prakashlab/octopi-driver-board/ODSv1.0.0-BP-Jmp/ODSv1.0.0-BP-Jmp.kicad_pcb

## KiCad design ODSv1.0.0-BP-Jmp/ODSv1.0.0-BP-Jmp.kicad_pcb (2021-03-19)

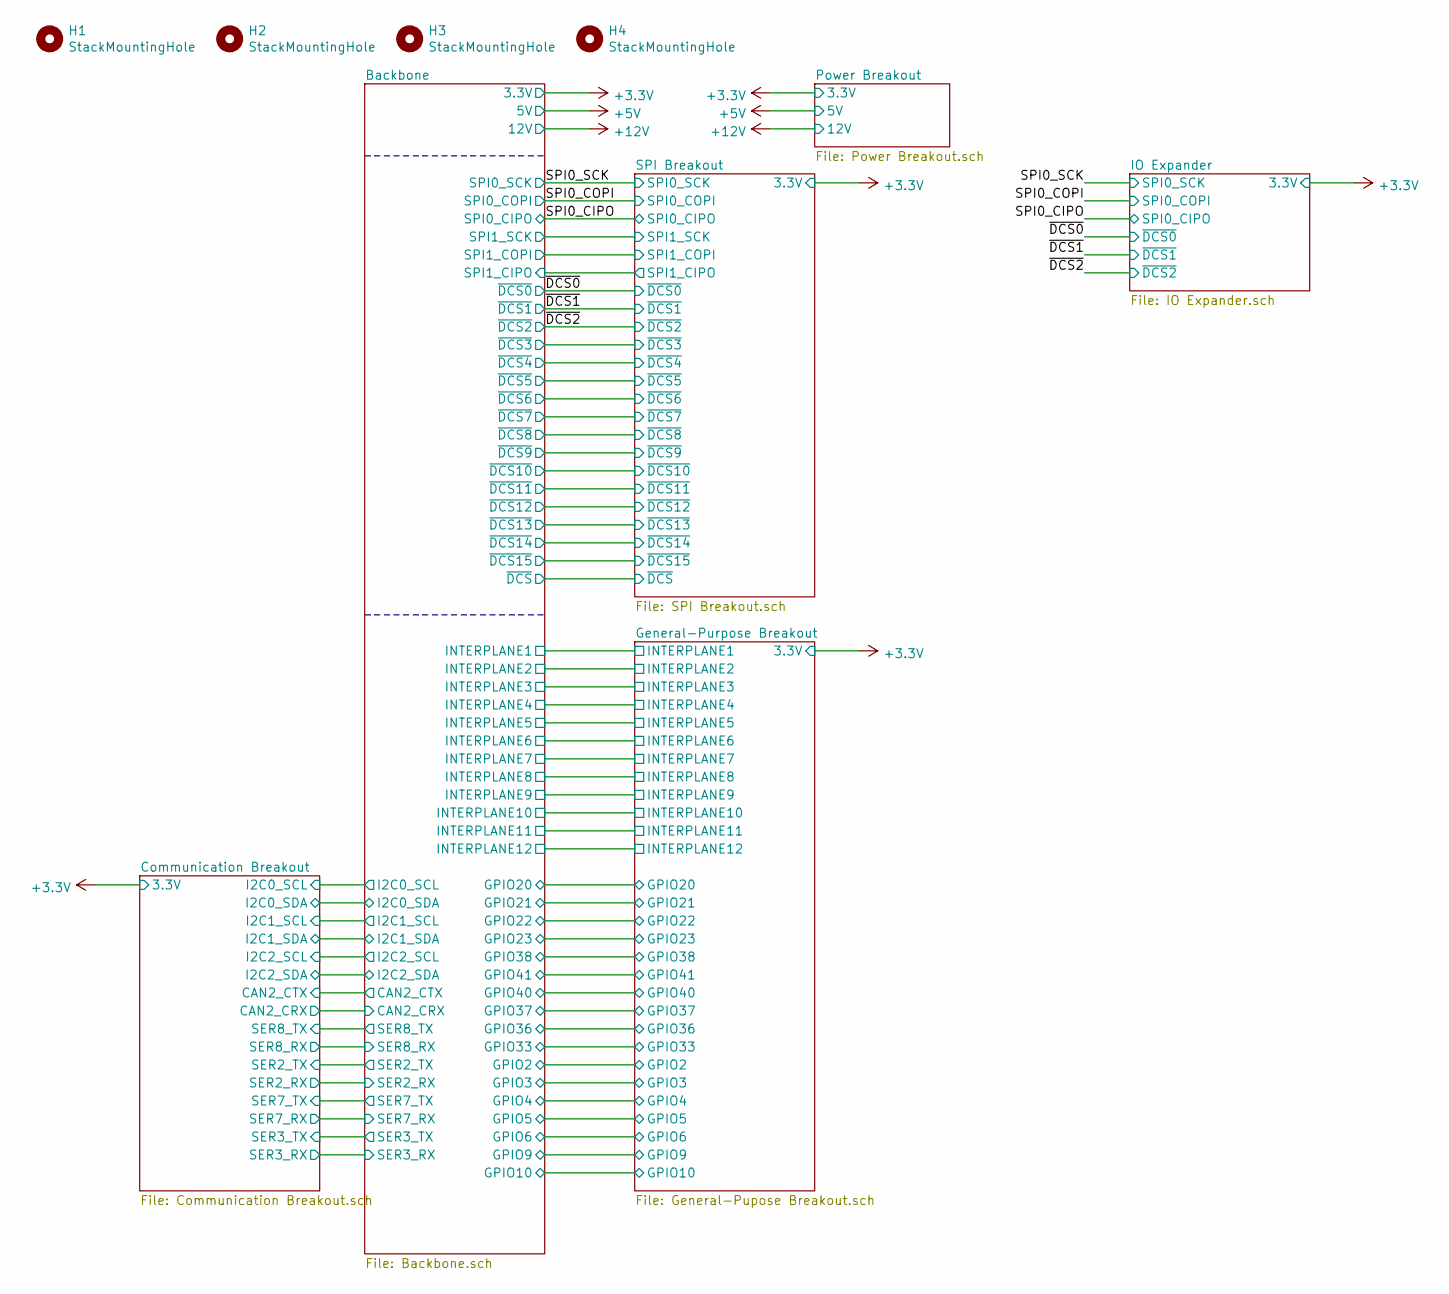
[picture p3: schematic ODSv1.0.0-BP-Jmp.sch, Breakout Plane for Jumper Wires]

Parts:
H1, H2, H3, H4: StackMountingHole; MountingHole_3.2mm_M3

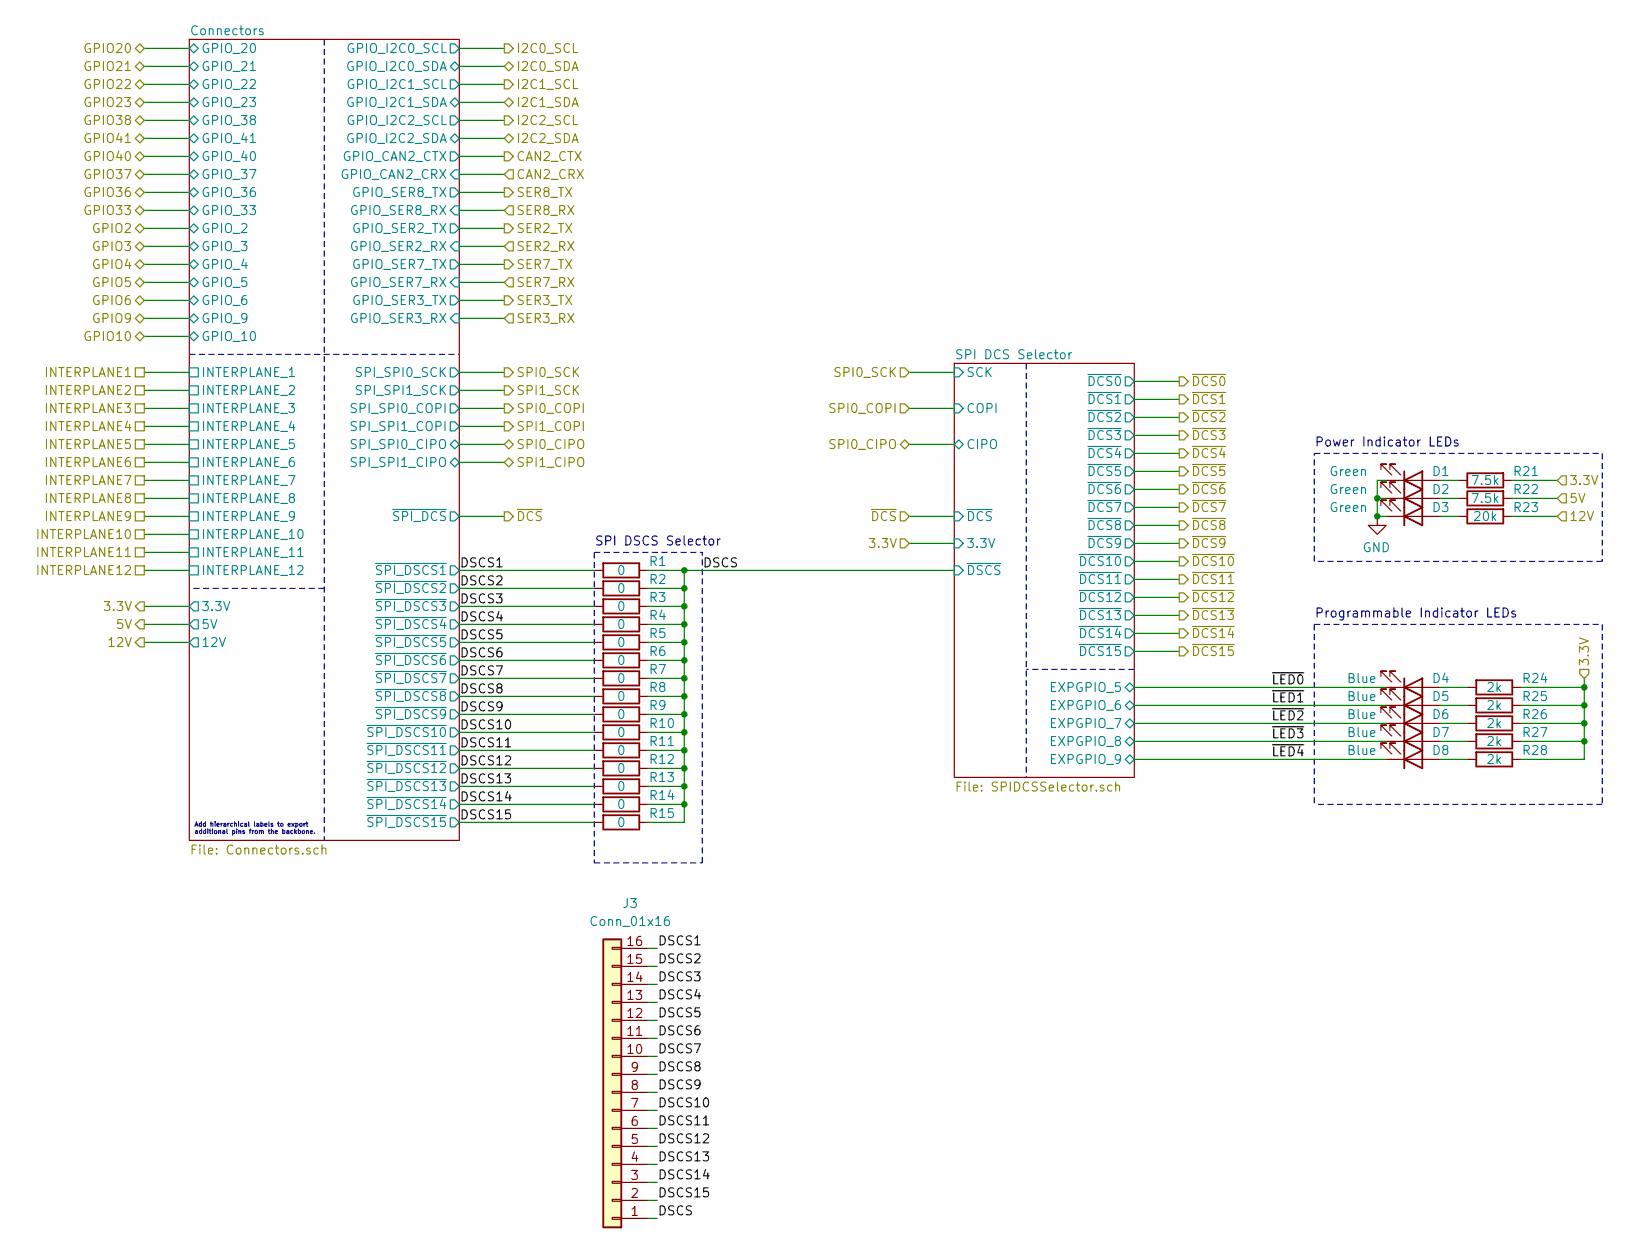
[picture p4: schematic Backbone.sch, Breakout Plane for Jumper Wires]

Parts:
D1, D2, D3: Green; LED_0603_1608Metric; MPN 150060GS75000; Digikey ID 732-4971-1-ND
D4, D5, D6, D7, D8: Blue; LED_0603_1608Metric; MPN 150060BS75000; Digikey ID 732-4966-1-ND
J3: Conn_01x16; Harwin_M20-89016xx_1x16_P2.54mm_Horizontal; MPN GEC16SBSN-M89; Digikey ID S1113E-16-ND
R1, R2, R3, R4, R5, R6, R7, R8, R9, R10, R11, R12, R13, R14, R15: 0; R_1206_3216Metric_Pad1.30x1.75mm_HandSolder; MPN RC1206JR-070RL; Digikey ID 311-0.0ERCT-ND
R21, R22: 7.5k; R_0603_1608Metric; MPN RC0603FR-077K5L; Digikey ID 311-7.50KHRCT-ND
R23: 20k; R_0603_1608Metric; MPN RC0603FR-0720KL; Digikey ID 311-20.0KHRCT-ND
R24, R25, R26, R27, R28: 2k; R_0603_1608Metric; MPN RC0603FR-0720KL; Digikey ID 311-20.0KHRCT-ND

Connections:
+3V3: R21.2, R24.1, R25.1, R26.1, R27.1, R28.1; also elsewhere on the board
+5V: R22.2; also elsewhere on the board
+12V: R23.2; also elsewhere on the board
/Backbone/DSCS: J3.1, R1.1, R2.1, R3.1, R4.1, R5.1, R6.1, R7.1, R8.1, R9.1, R10.1, R11.1, R12.1, R13.1, R14.1, R15.1; also elsewhere on the board
/Backbone/DSCS1: J3.16, R1.2; also elsewhere on the board
/Backbone/DSCS2: J3.15, R2.2; also elsewhere on the board
/Backbone/DSCS3: J3.14, R3.2; also elsewhere on the board
/Backbone/DSCS4: J3.13, R4.2; also elsewhere on the board
/Backbone/DSCS5: J3.12, R5.2; also elsewhere on the board
/Backbone/DSCS6: J3.11, R6.2; also elsewhere on the board
/Backbone/DSCS7: J3.10, R7.2; also elsewhere on the board
/Backbone/DSCS8: J3.9, R8.2; also elsewhere on the board
/Backbone/DSCS9: J3.8, R9.2; also elsewhere on the board
/Backbone/DSCS10: J3.7, R10.2; also elsewhere on the board
/Backbone/DSCS11: J3.6, R11.2; also elsewhere on the board
/Backbone/DSCS12: J3.5, R12.2; also elsewhere on the board
/Backbone/DSCS13: J3.4, R13.2; also elsewhere on the board
/Backbone/DSCS14: J3.3, R14.2; also elsewhere on the board
/Backbone/DSCS15: J3.2, R15.2; also elsewhere on the board
/Backbone/~LED0~: D4.1 (K); also elsewhere on the board
/Backbone/~LED1~: D5.1 (K); also elsewhere on the board
/Backbone/~LED2~: D6.1 (K); also elsewhere on the board
/Backbone/~LED3~: D7.1 (K); also elsewhere on the board
/Backbone/~LED4~: D8.1 (K); also elsewhere on the board
GND: D1.1 (K), D2.1 (K), D3.1 (K); also elsewhere on the board
unnamed: D1.2 (A), R21.1
unnamed: D2.2 (A), R22.1
unnamed: D3.2 (A), R23.1
unnamed: D4.2 (A), R24.2
unnamed: D5.2 (A), R25.2
unnamed: D6.2 (A), R26.2
unnamed: D7.2 (A), R27.2
unnamed: D8.2 (A), R28.2

Notes on the sheet:
SPI DSCS Selector
Power Indicator LEDs
Programmable Indicator LEDs
Add hierarchical labels to export additional pins from the backbone.

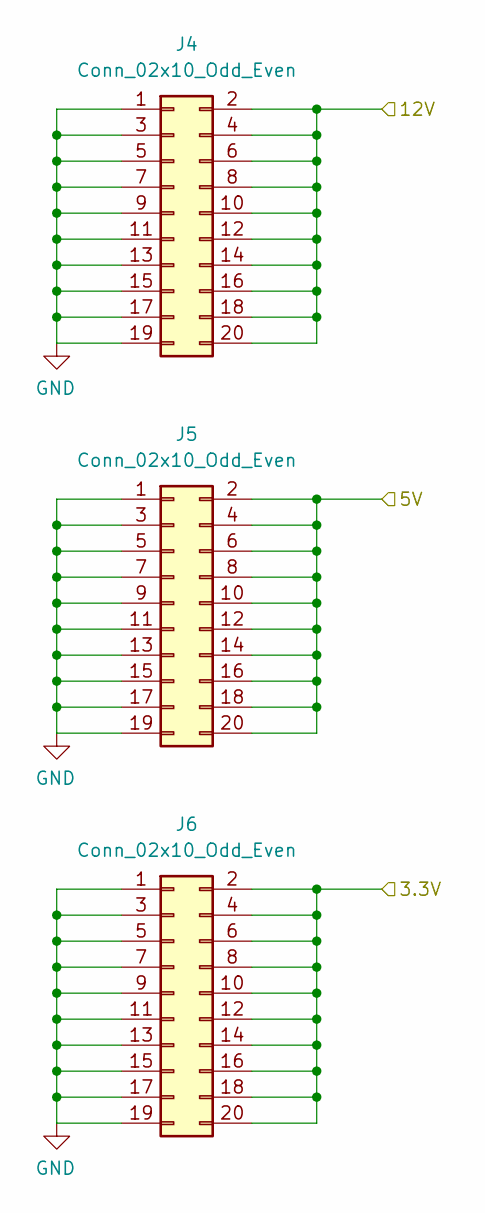
[picture p5: schematic Power Breakout.sch, Breakout Plane for Jumper Wires]

Parts:
J4, J5, J6: Conn_02x10_Odd_Even; Samtec_TSM-110-01-X-DH_2x10_P2.54mm_Horizontal; MPN TSM-110-01-T-DH; Digikey ID SAM15910-ND

Connections:
+3V3: J6.2, J6.4, J6.6, J6.8, J6.10, J6.12, J6.14, J6.16, J6.18, J6.20; also elsewhere on the board
+5V: J5.2, J5.4, J5.6, J5.8, J5.10, J5.12, J5.14, J5.16, J5.18, J5.20; also elsewhere on the board
+12V: J4.2, J4.4, J4.6, J4.8, J4.10, J4.12, J4.14, J4.16, J4.18, J4.20; also elsewhere on the board
GND: J4.1, J4.3, J4.5, J4.7, J4.9, J4.11, J4.13, J4.15, J4.17, J4.19, J5.1, J5.3, J5.5, J5.7, J5.9, J5.11, J5.13, J5.15, J5.17, J5.19, J6.1, J6.3, J6.5, J6.7, J6.9, J6.11, J6.13, J6.15, J6.17, J6.19; also elsewhere on the board

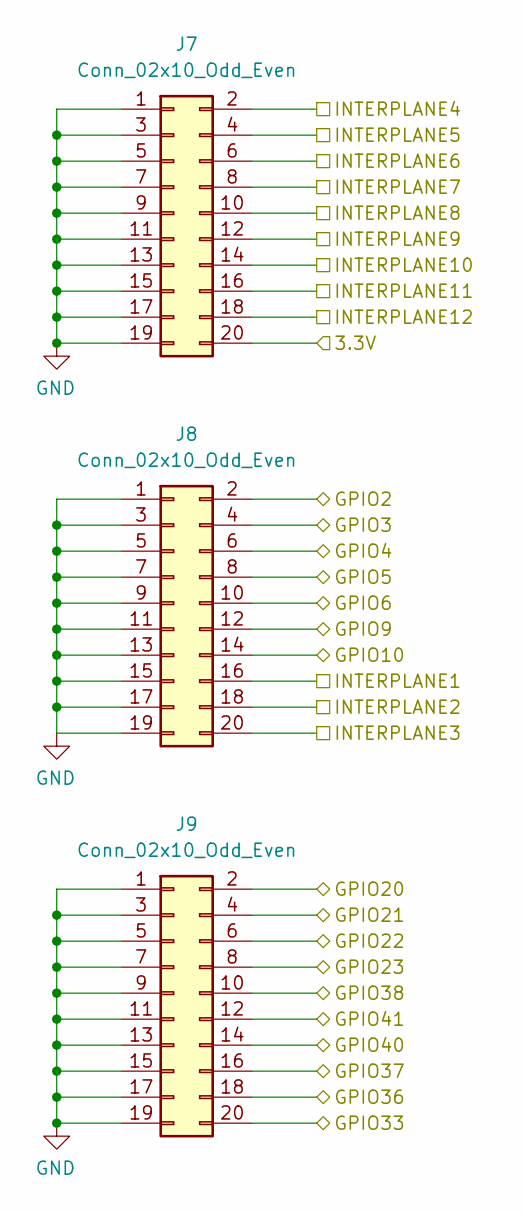
[picture p6: schematic General-Pupose Breakout.sch, Breakout Plane for Jumper Wires]

Parts:
J7, J8, J9: Conn_02x10_Odd_Even; Samtec_TSM-110-01-X-DH_2x10_P2.54mm_Horizontal; MPN TSM-110-01-T-DH; Digikey ID SAM15910-ND

Connections:
+3V3: J7.20; also elsewhere on the board
/Backbone/GPIO2: J8.2; also elsewhere on the board
/Backbone/GPIO3: J8.4; also elsewhere on the board
/Backbone/GPIO4: J8.6; also elsewhere on the board
/Backbone/GPIO5: J8.8; also elsewhere on the board
/Backbone/GPIO6: J8.10; also elsewhere on the board
/Backbone/GPIO9: J8.12; also elsewhere on the board
/Backbone/GPIO10: J8.14; also elsewhere on the board
/Backbone/GPIO20: J9.2; also elsewhere on the board
/Backbone/GPIO21: J9.4; also elsewhere on the board
/Backbone/GPIO22: J9.6; also elsewhere on the board
/Backbone/GPIO23: J9.8; also elsewhere on the board
/Backbone/GPIO33: J9.20; also elsewhere on the board
/Backbone/GPIO36: J9.18; also elsewhere on the board
/Backbone/GPIO37: J9.16; also elsewhere on the board
/Backbone/GPIO38: J9.10; also elsewhere on the board
/Backbone/GPIO40: J9.14; also elsewhere on the board
/Backbone/GPIO41: J9.12; also elsewhere on the board
/Backbone/INTERPLANE1: J8.16; also elsewhere on the board
/Backbone/INTERPLANE2: J8.18; also elsewhere on the board
/Backbone/INTERPLANE3: J8.20; also elsewhere on the board
/Backbone/INTERPLANE4: J7.2; also elsewhere on the board
/Backbone/INTERPLANE5: J7.4; also elsewhere on the board
/Backbone/INTERPLANE6: J7.6; also elsewhere on the board
/Backbone/INTERPLANE7: J7.8; also elsewhere on the board
/Backbone/INTERPLANE8: J7.10; also elsewhere on the board
/Backbone/INTERPLANE9: J7.12; also elsewhere on the board
/Backbone/INTERPLANE10: J7.14; also elsewhere on the board
/Backbone/INTERPLANE11: J7.16; also elsewhere on the board
/Backbone/INTERPLANE12: J7.18; also elsewhere on the board
GND: J7.1, J7.3, J7.5, J7.7, J7.9, J7.11, J7.13, J7.15, J7.17, J7.19, J8.1, J8.3, J8.5, J8.7, J8.9, J8.11, J8.13, J8.15, J8.17, J8.19, J9.1, J9.3, J9.5, J9.7, J9.9, J9.11, J9.13, J9.15, J9.17, J9.19; also elsewhere on the board

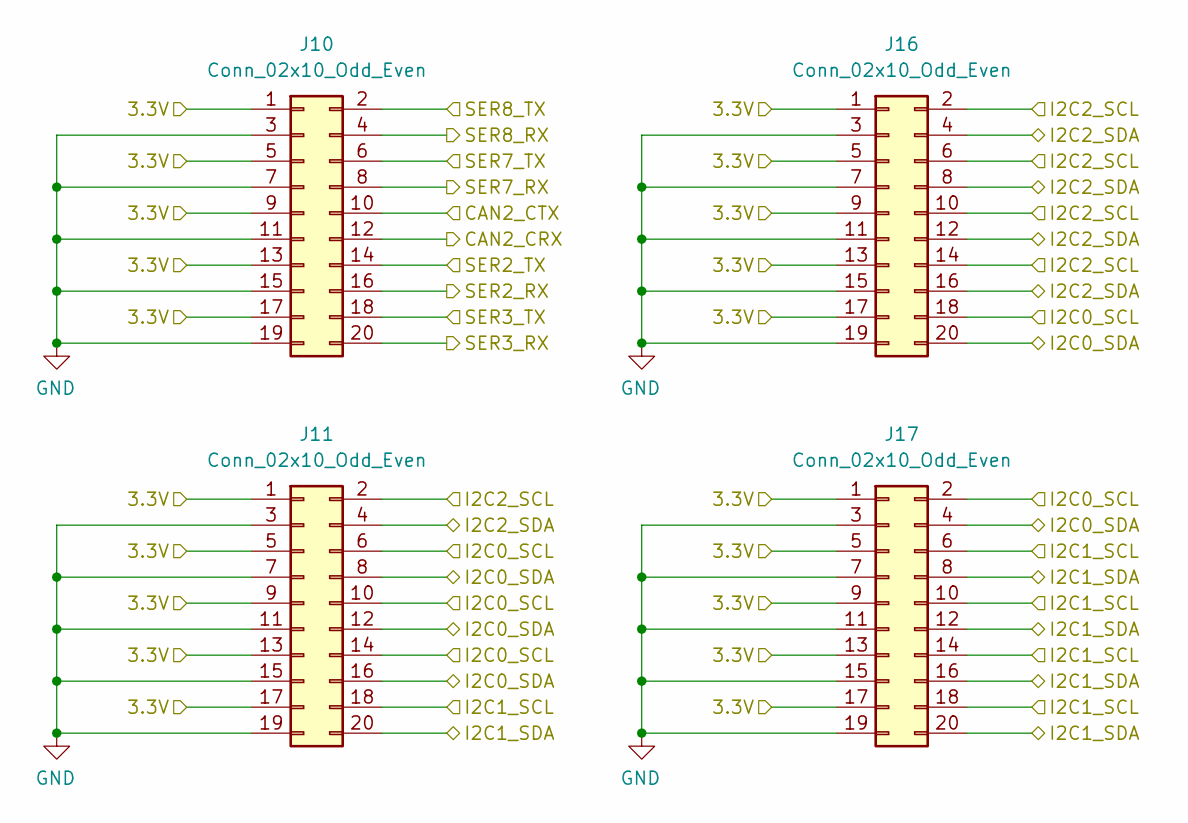
[picture p7: schematic Communication Breakout.sch, Breakout Plane for Jumper Wires]

Parts:
J10, J11: Conn_02x10_Odd_Even; Samtec_TSM-110-01-X-DH_2x10_P2.54mm_Horizontal; MPN TSM-110-01-T-DH; Digikey ID SAM15910-ND
J16, J17: Conn_02x10_Odd_Even; PinHeader_2x10_P2.54mm_Vertical_SMD; MPN TSM-110-01-T-DV; Digikey ID SAM8990-ND

Connections:
+3V3: J10.1, J10.5, J10.9, J10.13, J10.17, J11.1, J11.5, J11.9, J11.13, J11.17, J16.1, J16.5, J16.9, J16.13, J16.17, J17.1, J17.5, J17.9, J17.13, J17.17; also elsewhere on the board
/Backbone/CAN2_CRX: J10.12; also elsewhere on the board
/Backbone/CAN2_CTX: J10.10; also elsewhere on the board
/Backbone/I2C0_SCL: J11.6, J11.10, J11.14, J16.18, J17.2; also elsewhere on the board
/Backbone/I2C0_SDA: J11.8, J11.12, J11.16, J16.20, J17.4; also elsewhere on the board
/Backbone/I2C1_SCL: J11.18, J17.6, J17.10, J17.14, J17.18; also elsewhere on the board
/Backbone/I2C1_SDA: J11.20, J17.8, J17.12, J17.16, J17.20; also elsewhere on the board
/Backbone/I2C2_SCL: J11.2, J16.2, J16.6, J16.10, J16.14; also elsewhere on the board
/Backbone/I2C2_SDA: J11.4, J16.4, J16.8, J16.12, J16.16; also elsewhere on the board
/Backbone/SER2_RX: J10.16; also elsewhere on the board
/Backbone/SER2_TX: J10.14; also elsewhere on the board
/Backbone/SER3_RX: J10.20; also elsewhere on the board
/Backbone/SER3_TX: J10.18; also elsewhere on the board
/Backbone/SER7_RX: J10.8; also elsewhere on the board
/Backbone/SER7_TX: J10.6; also elsewhere on the board
/Backbone/SER8_RX: J10.4; also elsewhere on the board
/Backbone/SER8_TX: J10.2; also elsewhere on the board
GND: J10.3, J10.7, J10.11, J10.15, J10.19, J11.3, J11.7, J11.11, J11.15, J11.19, J16.3, J16.7, J16.11, J16.15, J16.19, J17.3, J17.7, J17.11, J17.15, J17.19; also elsewhere on the board

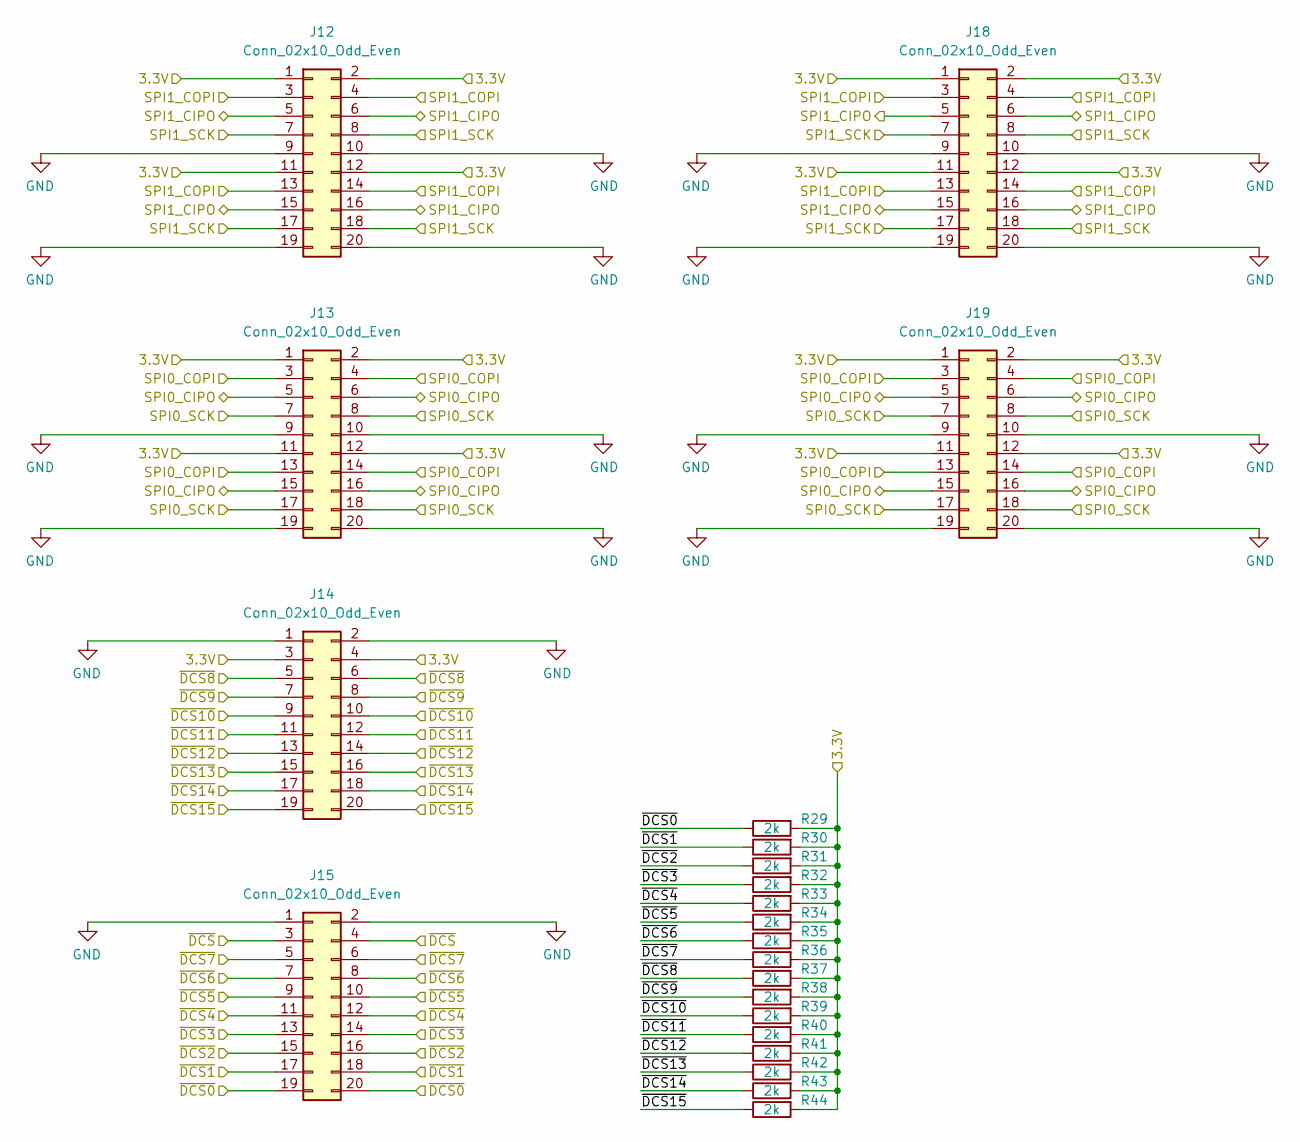
[picture p8: schematic SPI Breakout.sch, Breakout Plane for Jumper Wires]

Parts:
J12, J13, J14: Conn_02x10_Odd_Even; Samtec_TSM-110-01-X-DH_2x10_P2.54mm_Horizontal; MPN TSM-110-01-T-DH; Digikey ID SAM15910-ND
J15, J18, J19: Conn_02x10_Odd_Even; PinHeader_2x10_P2.54mm_Vertical_SMD; MPN TSM-110-01-T-DV; Digikey ID SAM8990-ND
R29, R30, R31, R32, R33, R34, R35, R36, R37, R38, R39, R40, R41, R42, R43, R44: 2k; R_0603_1608Metric; MPN RC0603FR-0720KL; Digikey ID 311-20.0KHRCT-ND

Connections:
+3V3: J12.1, J12.2, J12.11, J12.12, J13.1, J13.2, J13.11, J13.12, J14.3, J14.4, J18.1, J18.2, J18.11, J18.12, J19.1, J19.2, J19.11, J19.12, R29.2, R30.2, R31.2, R32.2, R33.2, R34.2, R35.2, R36.2, R37.2, R38.2, R39.2, R40.2, R41.2, R42.2, R43.2, R44.2; also elsewhere on the board
/Backbone/SPI1_CIPO: J12.5, J12.6, J12.15, J12.16, J18.5, J18.6, J18.15, J18.16; also elsewhere on the board
/Backbone/SPI1_COPI: J12.3, J12.4, J12.13, J12.14, J18.3, J18.4, J18.13, J18.14; also elsewhere on the board
/Backbone/SPI1_SCK: J12.7, J12.8, J12.17, J12.18, J18.7, J18.8, J18.17, J18.18; also elsewhere on the board
/Backbone/~DCS3~: J15.13, J15.14, R32.1; also elsewhere on the board
/Backbone/~DCS4~: J15.11, J15.12, R33.1; also elsewhere on the board
/Backbone/~DCS5~: J15.9, J15.10, R34.1; also elsewhere on the board
/Backbone/~DCS6~: J15.7, J15.8, R35.1; also elsewhere on the board
/Backbone/~DCS7~: J15.5, J15.6, R36.1; also elsewhere on the board
/Backbone/~DCS8~: J14.5, J14.6, R37.1; also elsewhere on the board
/Backbone/~DCS9~: J14.7, J14.8, R38.1; also elsewhere on the board
/Backbone/~DCS10~: J14.9, J14.10, R39.1; also elsewhere on the board
/Backbone/~DCS11~: J14.11, J14.12, R40.1; also elsewhere on the board
/Backbone/~DCS12~: J14.13, J14.14, R41.1; also elsewhere on the board
/Backbone/~DCS13~: J14.15, J14.16, R42.1; also elsewhere on the board
/Backbone/~DCS14~: J14.17, J14.18, R43.1; also elsewhere on the board
/Backbone/~DCS15~: J14.19, J14.20, R44.1; also elsewhere on the board
/Backbone/~DCS~: J15.3, J15.4; also elsewhere on the board
/SPI0_CIPO: J13.5, J13.6, J13.15, J13.16, J19.5, J19.6, J19.15, J19.16; also elsewhere on the board
/SPI0_COPI: J13.3, J13.4, J13.13, J13.14, J19.3, J19.4, J19.13, J19.14; also elsewhere on the board
/SPI0_SCK: J13.7, J13.8, J13.17, J13.18, J19.7, J19.8, J19.17, J19.18; also elsewhere on the board
/~DCS0~: J15.19, J15.20, R29.1; also elsewhere on the board
/~DCS1~: J15.17, J15.18, R30.1; also elsewhere on the board
/~DCS2~: J15.15, J15.16, R31.1; also elsewhere on the board
GND: J12.9, J12.10, J12.19, J12.20, J13.9, J13.10, J13.19, J13.20, J14.1, J14.2, J15.1, J15.2, J18.9, J18.10, J18.19, J18.20, J19.9, J19.10, J19.19, J19.20; also elsewhere on the board
