prakashlab/octopi-driver-board/ODSv1.0.0-BP-Jmp/ODSv1.0.0-BP-Jmp.kicad_pcb

## KiCad design ODSv1.0.0-BP-Jmp/ODSv1.0.0-BP-Jmp.kicad_pcb (continued)

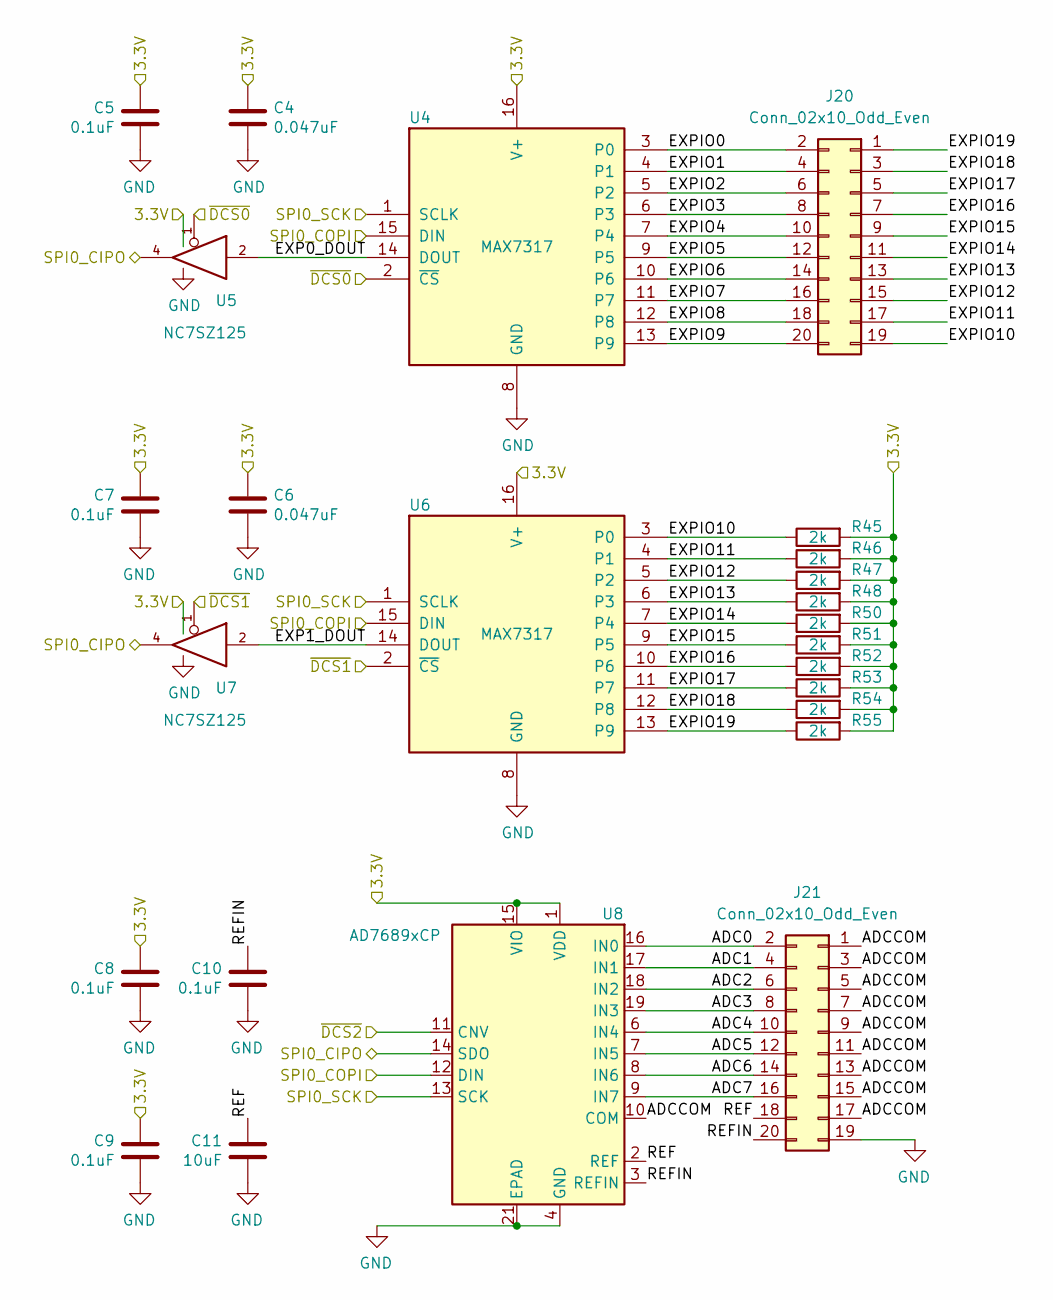
[picture p9: schematic IO Expander.sch, Breakout Plane for Jumper Wires]

Parts:
C4, C6: 0.047uF; C_0603_1608Metric; MPN 06033C473KAT2A; Digikey ID 478-1235-1-ND
C5, C7, C8, C9, C10: 0.1uF; C_0603_1608Metric; MPN 06033C104KAT4A; Digikey ID 478-7018-1-ND
C11: 10uF; C_0805_2012Metric; MPN 0805ZC106KAT2A; Digikey ID 478-10578-1-ND
J20, J21: Conn_02x10_Odd_Even; PinHeader_2x10_P2.54mm_Vertical_SMD; MPN TSM-110-01-T-DV; Digikey ID SAM8990-ND
R45, R46, R47, R48, R50, R51, R52, R53, R54, R55: 2k; R_0603_1608Metric; MPN RC0603FR-0720KL; Digikey ID 311-20.0KHRCT-ND
U4, U6: MAX7317; QSOP-16_3.9x4.9mm_P0.635mm; MPN MAX7317AEE+T; Digikey ID MAX7317AEE+TCT-ND
U5, U7: NC7SZ125; SOT-353_SC-70-5; MPN NC7SZ125P5X; Digikey ID NC7SZ125P5XCT-ND
U8: AD7689xCP; LFCSP-20-1EP_4x4mm_P0.5mm_EP2.5x2.5mm; MPN AD7689BCPZRL7; Digikey ID AD7689BCPZRL7CT-ND

Connections:
+3V3: C4.1, C5.1, C6.1, C7.1, C8.1, C9.1, R45.2, R46.2, R47.2, R48.2, R50.2, R51.2, R52.2, R53.2, R54.2, R55.2, U4.16 (V+), U5.5 (VCC), U6.16 (V+), U7.5 (VCC), U8.1 (VDD), U8.15 (VIO), U8.20 (VDD); also elsewhere on the board
/IO Expander/ADC0: J21.2, U8.16 (IN0)
/IO Expander/ADC1: J21.4, U8.17 (IN1)
/IO Expander/ADC2: J21.6, U8.18 (IN2)
/IO Expander/ADC3: J21.8, U8.19 (IN3)
/IO Expander/ADC4: J21.10, U8.6 (IN4)
/IO Expander/ADC5: J21.12, U8.7 (IN5)
/IO Expander/ADC6: J21.14, U8.8 (IN6)
/IO Expander/ADC7: J21.16, U8.9 (IN7)
/IO Expander/ADCCOM: J21.1, J21.3, J21.5, J21.7, J21.9, J21.11, J21.13, J21.15, J21.17, U8.10 (COM)
/IO Expander/EXP0_DOUT: U4.14 (DOUT), U5.2
/IO Expander/EXP1_DOUT: U6.14 (DOUT), U7.2
/IO Expander/EXPIO0: J20.2, U4.3 (P0)
/IO Expander/EXPIO1: J20.4, U4.4 (P1)
/IO Expander/EXPIO2: J20.6, U4.5 (P2)
/IO Expander/EXPIO3: J20.8, U4.6 (P3)
/IO Expander/EXPIO4: J20.10, U4.7 (P4)
/IO Expander/EXPIO5: J20.12, U4.9 (P5)
/IO Expander/EXPIO6: J20.14, U4.10 (P6)
/IO Expander/EXPIO7: J20.16, U4.11 (P7)
/IO Expander/EXPIO8: J20.18, U4.12 (P8)
/IO Expander/EXPIO9: J20.20, U4.13 (P9)
/IO Expander/EXPIO10: J20.19, R45.1, U6.3 (P0)
/IO Expander/EXPIO11: J20.17, R46.1, U6.4 (P1)
/IO Expander/EXPIO12: J20.15, R47.1, U6.5 (P2)
/IO Expander/EXPIO13: J20.13, R48.1, U6.6 (P3)
/IO Expander/EXPIO14: J20.11, R50.1, U6.7 (P4)
/IO Expander/EXPIO15: J20.9, R51.1, U6.9 (P5)
/IO Expander/EXPIO16: J20.7, R52.1, U6.10 (P6)
/IO Expander/EXPIO17: J20.5, R53.1, U6.11 (P7)
/IO Expander/EXPIO18: J20.3, R54.1, U6.12 (P8)
/IO Expander/EXPIO19: J20.1, R55.1, U6.13 (P9)
/IO Expander/REF: C11.1, J21.18, U8.2 (REF)
/IO Expander/REFIN: C10.1, J21.20, U8.3 (REFIN)
/SPI0_CIPO: U5.4, U7.4, U8.14 (SDO); also elsewhere on the board
/SPI0_COPI: U4.15 (DIN), U6.15 (DIN), U8.12 (DIN); also elsewhere on the board
/SPI0_SCK: U4.1 (SCLK), U6.1 (SCLK), U8.13 (SCK); also elsewhere on the board
/~DCS0~: U4.2 (~CS~), U5.1; also elsewhere on the board
/~DCS1~: U6.2 (~CS~), U7.1; also elsewhere on the board
/~DCS2~: U8.11 (CNV); also elsewhere on the board
GND: C4.2, C5.2, C6.2, C7.2, C8.2, C9.2, C10.2, C11.2, J21.19, U4.8 (GND), U5.3 (GND), U6.8 (GND), U7.3 (GND), U8.4 (GND), U8.5 (GND), U8.21 (EPAD); also elsewhere on the board

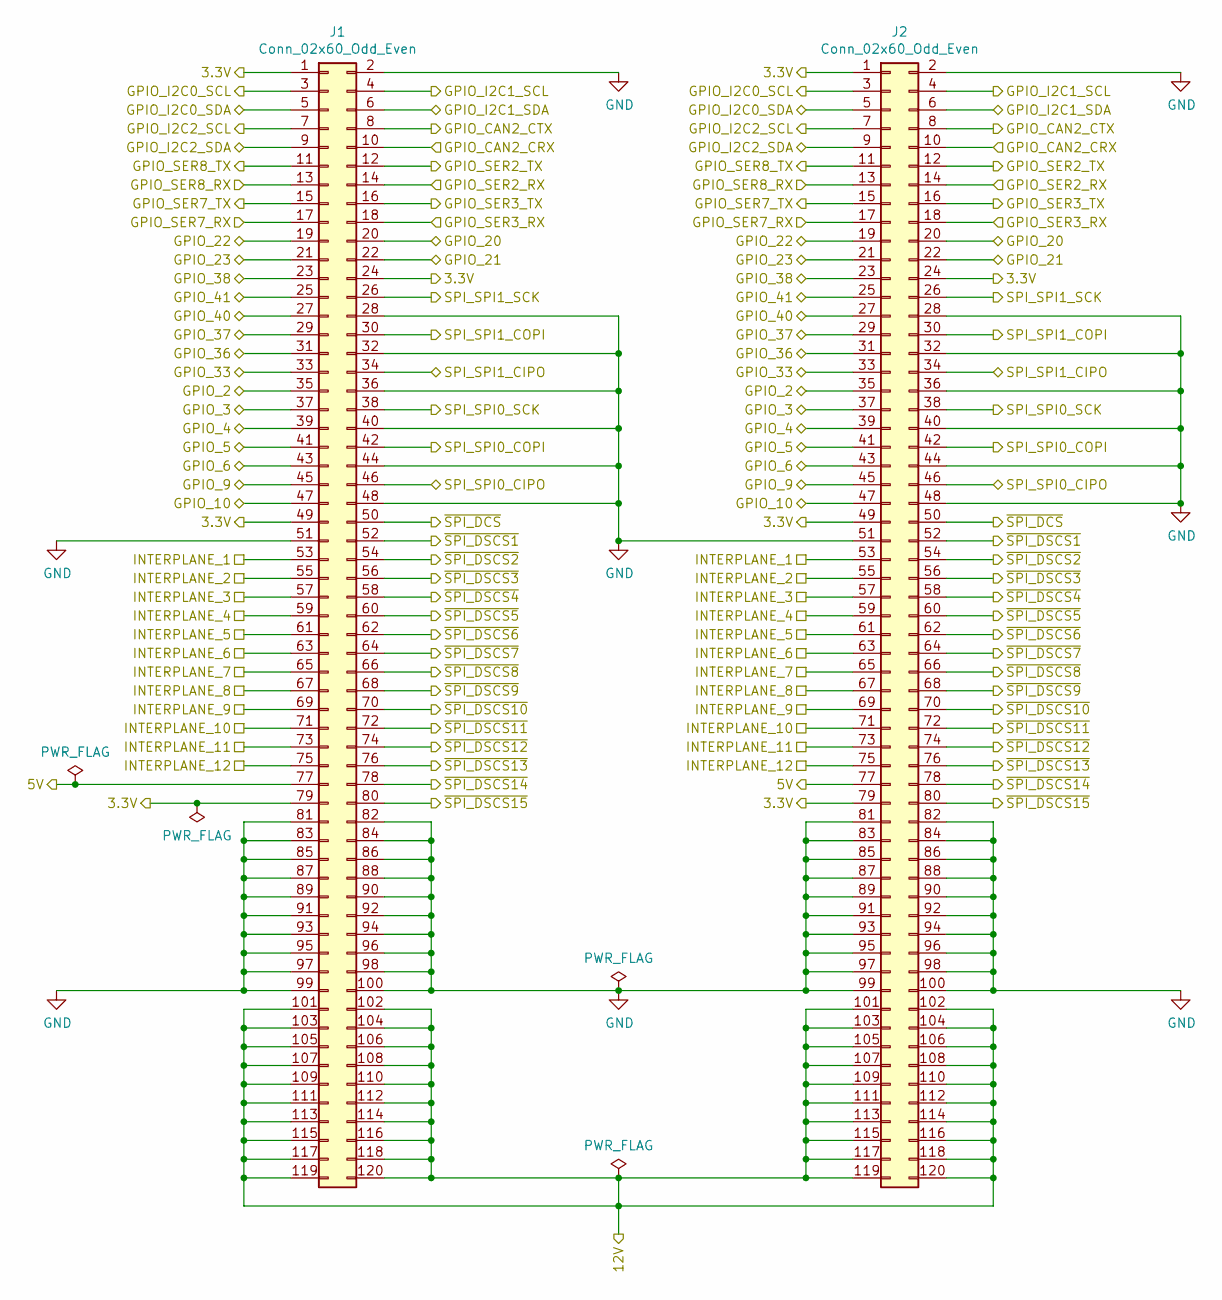
[picture p10: schematic Connectors.sch, Breakout Plane for Jumper Wires]

Parts:
J1: Conn_02x60_Odd_Even; Hirose_FX20_FX20-120P-0.5SV_2x60_P0.50mm_Vertical; MPN FX20-120P-0.5SV20; Digikey ID H12042-ND
J2: Conn_02x60_Odd_Even; Hirose_FX20_FX20-120S-0.5SV_2x60_P0.50mm_Vertical; MPN FX20-120S-0.5SV; Digikey ID H12041-ND

Connections:
+3V3: J1.1, J1.24, J1.49, J1.79, J2.1, J2.24, J2.49, J2.79; also elsewhere on the board
+5V: J1.77, J2.77; also elsewhere on the board
+12V: J1.101, J1.102, J1.103, J1.104, J1.105, J1.106, J1.107, J1.108, J1.109, J1.110, J1.111, J1.112, J1.113, J1.114, J1.115, J1.116, J1.117, J1.118, J1.119, J1.120, J2.101, J2.102, J2.103, J2.104, J2.105, J2.106, J2.107, J2.108, J2.109, J2.110, J2.111, J2.112, J2.113, J2.114, J2.115, J2.116, J2.117, J2.118, J2.119, J2.120; also elsewhere on the board
/Backbone/CAN2_CRX: J1.10, J2.10; also elsewhere on the board
/Backbone/CAN2_CTX: J1.8, J2.8; also elsewhere on the board
/Backbone/DSCS1: J1.52, J2.52; also elsewhere on the board
/Backbone/DSCS2: J1.54, J2.54; also elsewhere on the board
/Backbone/DSCS3: J1.56, J2.56; also elsewhere on the board
/Backbone/DSCS4: J1.58, J2.58; also elsewhere on the board
/Backbone/DSCS5: J1.60, J2.60; also elsewhere on the board
/Backbone/DSCS6: J1.62, J2.62; also elsewhere on the board
/Backbone/DSCS7: J1.64, J2.64; also elsewhere on the board
/Backbone/DSCS8: J1.66, J2.66; also elsewhere on the board
/Backbone/DSCS9: J1.68, J2.68; also elsewhere on the board
/Backbone/DSCS10: J1.70, J2.70; also elsewhere on the board
/Backbone/DSCS11: J1.72, J2.72; also elsewhere on the board
/Backbone/DSCS12: J1.74, J2.74; also elsewhere on the board
/Backbone/DSCS13: J1.76, J2.76; also elsewhere on the board
/Backbone/DSCS14: J1.78, J2.78; also elsewhere on the board
/Backbone/DSCS15: J1.80, J2.80; also elsewhere on the board
/Backbone/GPIO2: J1.35, J2.35; also elsewhere on the board
/Backbone/GPIO3: J1.37, J2.37; also elsewhere on the board
/Backbone/GPIO4: J1.39, J2.39; also elsewhere on the board
/Backbone/GPIO5: J1.41, J2.41; also elsewhere on the board
/Backbone/GPIO6: J1.43, J2.43; also elsewhere on the board
/Backbone/GPIO9: J1.45, J2.45; also elsewhere on the board
/Backbone/GPIO10: J1.47, J2.47; also elsewhere on the board
/Backbone/GPIO20: J1.20, J2.20; also elsewhere on the board
/Backbone/GPIO21: J1.22, J2.22; also elsewhere on the board
/Backbone/GPIO22: J1.19, J2.19; also elsewhere on the board
/Backbone/GPIO23: J1.21, J2.21; also elsewhere on the board
/Backbone/GPIO33: J1.33, J2.33; also elsewhere on the board
/Backbone/GPIO36: J1.31, J2.31; also elsewhere on the board
/Backbone/GPIO37: J1.29, J2.29; also elsewhere on the board
/Backbone/GPIO38: J1.23, J2.23; also elsewhere on the board
/Backbone/GPIO40: J1.27, J2.27; also elsewhere on the board
/Backbone/GPIO41: J1.25, J2.25; also elsewhere on the board
/Backbone/I2C0_SCL: J1.3, J2.3; also elsewhere on the board
/Backbone/I2C0_SDA: J1.5, J2.5; also elsewhere on the board
/Backbone/I2C1_SCL: J1.4, J2.4; also elsewhere on the board
/Backbone/I2C1_SDA: J1.6, J2.6; also elsewhere on the board
/Backbone/I2C2_SCL: J1.7, J2.7; also elsewhere on the board
/Backbone/I2C2_SDA: J1.9, J2.9; also elsewhere on the board
/Backbone/INTERPLANE1: J1.53, J2.53; also elsewhere on the board
/Backbone/INTERPLANE2: J1.55, J2.55; also elsewhere on the board
/Backbone/INTERPLANE3: J1.57, J2.57; also elsewhere on the board
/Backbone/INTERPLANE4: J1.59, J2.59; also elsewhere on the board
/Backbone/INTERPLANE5: J1.61, J2.61; also elsewhere on the board
/Backbone/INTERPLANE6: J1.63, J2.63; also elsewhere on the board
/Backbone/INTERPLANE7: J1.65, J2.65; also elsewhere on the board
/Backbone/INTERPLANE8: J1.67, J2.67; also elsewhere on the board
/Backbone/INTERPLANE9: J1.69, J2.69; also elsewhere on the board
/Backbone/INTERPLANE10: J1.71, J2.71; also elsewhere on the board
/Backbone/INTERPLANE11: J1.73, J2.73; also elsewhere on the board
/Backbone/INTERPLANE12: J1.75, J2.75; also elsewhere on the board
/Backbone/SER2_RX: J1.14, J2.14; also elsewhere on the board
/Backbone/SER2_TX: J1.12, J2.12; also elsewhere on the board
/Backbone/SER3_RX: J1.18, J2.18; also elsewhere on the board
/Backbone/SER3_TX: J1.16, J2.16; also elsewhere on the board
/Backbone/SER7_RX: J1.17, J2.17; also elsewhere on the board
/Backbone/SER7_TX: J1.15, J2.15; also elsewhere on the board
/Backbone/SER8_RX: J1.13, J2.13; also elsewhere on the board
/Backbone/SER8_TX: J1.11, J2.11; also elsewhere on the board
/Backbone/SPI1_CIPO: J1.34, J2.34; also elsewhere on the board
/Backbone/SPI1_COPI: J1.30, J2.30; also elsewhere on the board
/Backbone/SPI1_SCK: J1.26, J2.26; also elsewhere on the board
/Backbone/~DCS~: J1.50, J2.50; also elsewhere on the board
/SPI0_CIPO: J1.46, J2.46; also elsewhere on the board
/SPI0_COPI: J1.42, J2.42; also elsewhere on the board
/SPI0_SCK: J1.38, J2.38; also elsewhere on the board
GND: J1.2, J1.28, J1.32, J1.36, J1.40, J1.44, J1.48, J1.51, J1.81, J1.82, J1.83, J1.84, J1.85, J1.86, J1.87, J1.88, J1.89, J1.90, J1.91, J1.92, J1.93, J1.94, J1.95, J1.96, J1.97, J1.98, J1.99, J1.100, J2.2, J2.28, J2.32, J2.36, J2.40, J2.44, J2.48, J2.51, J2.81, J2.82, J2.83, J2.84, J2.85, J2.86, J2.87, J2.88, J2.89, J2.90, J2.91, J2.92, J2.93, J2.94, J2.95, J2.96, J2.97, J2.98, J2.99, J2.100; also elsewhere on the board

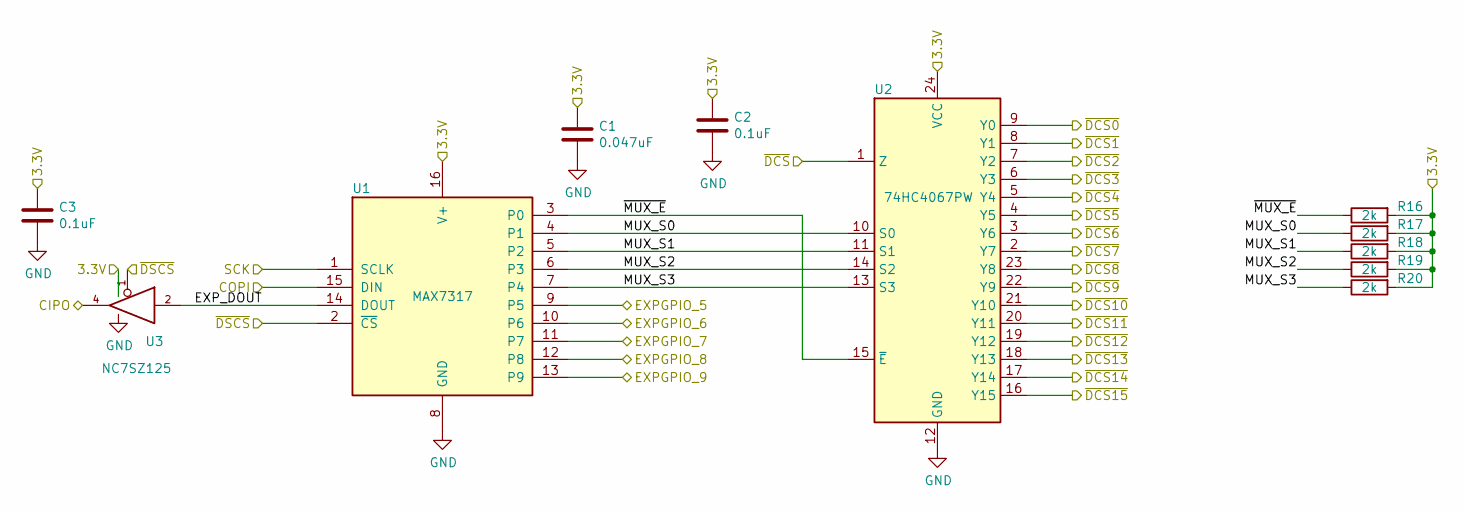
[picture p11: schematic SPIDCSSelector.sch, Breakout Plane for Jumper Wires]

Parts:
C1: 0.047uF; C_0603_1608Metric; MPN 06033C473KAT2A; Digikey ID 478-1235-1-ND
C2, C3: 0.1uF; C_0603_1608Metric; MPN 06033C104KAT4A; Digikey ID 478-7018-1-ND
R16, R17, R18, R19, R20: 2k; R_0603_1608Metric; MPN RC0603FR-0720KL; Digikey ID 311-20.0KHRCT-ND
U1: MAX7317; QSOP-16_3.9x4.9mm_P0.635mm; MPN MAX7317AEE+T; Digikey ID MAX7317AEE+TCT-ND
U2: 74HC4067PW; TSSOP-24_4.4x7.8mm_P0.65mm; MPN 74HC4067PW,118; Digikey ID 1727-2042-1-ND
U3: NC7SZ125; SOT-353_SC-70-5; MPN NC7SZ125P5X; Digikey ID NC7SZ125P5XCT-ND

Connections:
+3V3: C1.1, C2.1, C3.1, R16.2, R17.2, R18.2, R19.2, R20.2, U1.16 (V+), U2.24 (VCC), U3.5 (VCC); also elsewhere on the board
/Backbone/DSCS: U1.2 (~CS~), U3.1; also elsewhere on the board
/Backbone/SPI DCS Selector/EXP_DOUT: U1.14 (DOUT), U3.2
/Backbone/SPI DCS Selector/MUX_S0: R17.1, U1.4 (P1), U2.10 (S0)
/Backbone/SPI DCS Selector/MUX_S1: R18.1, U1.5 (P2), U2.11 (S1)
/Backbone/SPI DCS Selector/MUX_S2: R19.1, U1.6 (P3), U2.14 (S2)
/Backbone/SPI DCS Selector/MUX_S3: R20.1, U1.7 (P4), U2.13 (S3)
/Backbone/SPI DCS Selector/~MUX_E~: R16.1, U1.3 (P0), U2.15 (~E)
/Backbone/~DCS3~: U2.6 (Y3); also elsewhere on the board
/Backbone/~DCS4~: U2.5 (Y4); also elsewhere on the board
/Backbone/~DCS5~: U2.4 (Y5); also elsewhere on the board
/Backbone/~DCS6~: U2.3 (Y6); also elsewhere on the board
/Backbone/~DCS7~: U2.2 (Y7); also elsewhere on the board
/Backbone/~DCS8~: U2.23 (Y8); also elsewhere on the board
/Backbone/~DCS9~: U2.22 (Y9); also elsewhere on the board
/Backbone/~DCS10~: U2.21 (Y10); also elsewhere on the board
/Backbone/~DCS11~: U2.20 (Y11); also elsewhere on the board
/Backbone/~DCS12~: U2.19 (Y12); also elsewhere on the board
/Backbone/~DCS13~: U2.18 (Y13); also elsewhere on the board
/Backbone/~DCS14~: U2.17 (Y14); also elsewhere on the board
/Backbone/~DCS15~: U2.16 (Y15); also elsewhere on the board
/Backbone/~DCS~: U2.1 (Z); also elsewhere on the board
/Backbone/~LED0~: U1.9 (P5); also elsewhere on the board
/Backbone/~LED1~: U1.10 (P6); also elsewhere on the board
/Backbone/~LED2~: U1.11 (P7); also elsewhere on the board
/Backbone/~LED3~: U1.12 (P8); also elsewhere on the board
/Backbone/~LED4~: U1.13 (P9); also elsewhere on the board
/SPI0_CIPO: U3.4; also elsewhere on the board
/SPI0_COPI: U1.15 (DIN); also elsewhere on the board
/SPI0_SCK: U1.1 (SCLK); also elsewhere on the board
/~DCS0~: U2.9 (Y0); also elsewhere on the board
/~DCS1~: U2.8 (Y1); also elsewhere on the board
/~DCS2~: U2.7 (Y2); also elsewhere on the board
GND: C1.2, C2.2, C3.2, U1.8 (GND), U2.12 (GND), U3.3 (GND); also elsewhere on the board

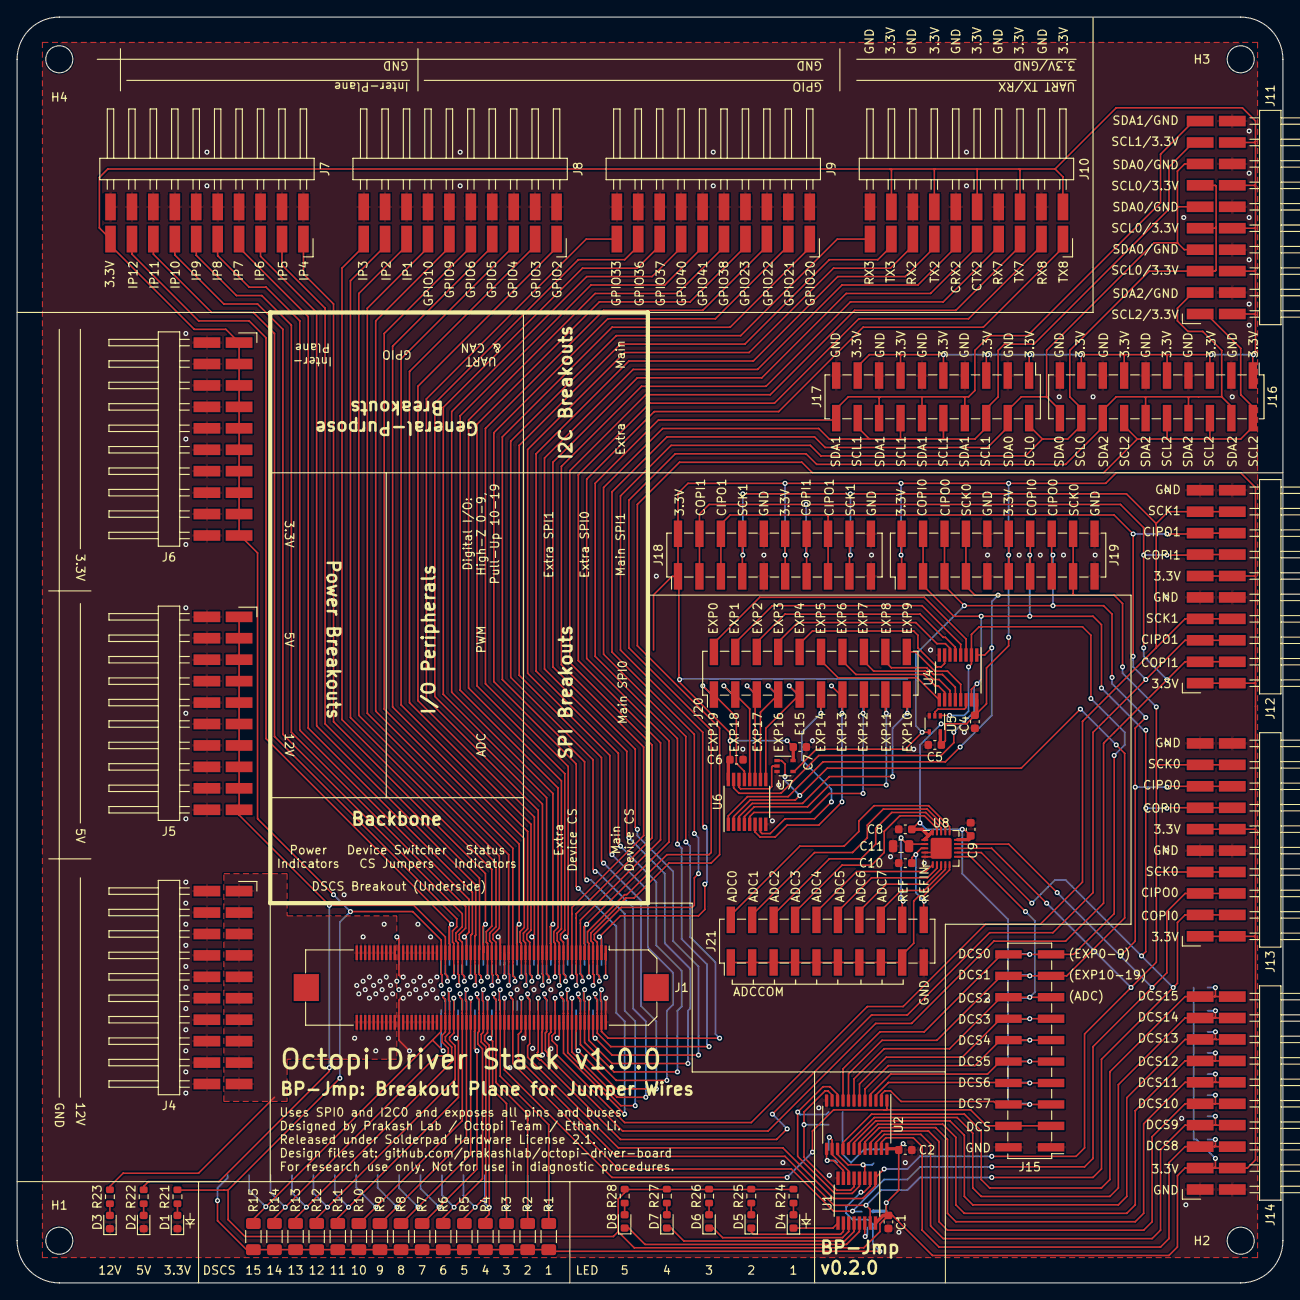
[picture p12: board ODSv1.0.0-BP-Jmp.kicad_pcb from above]

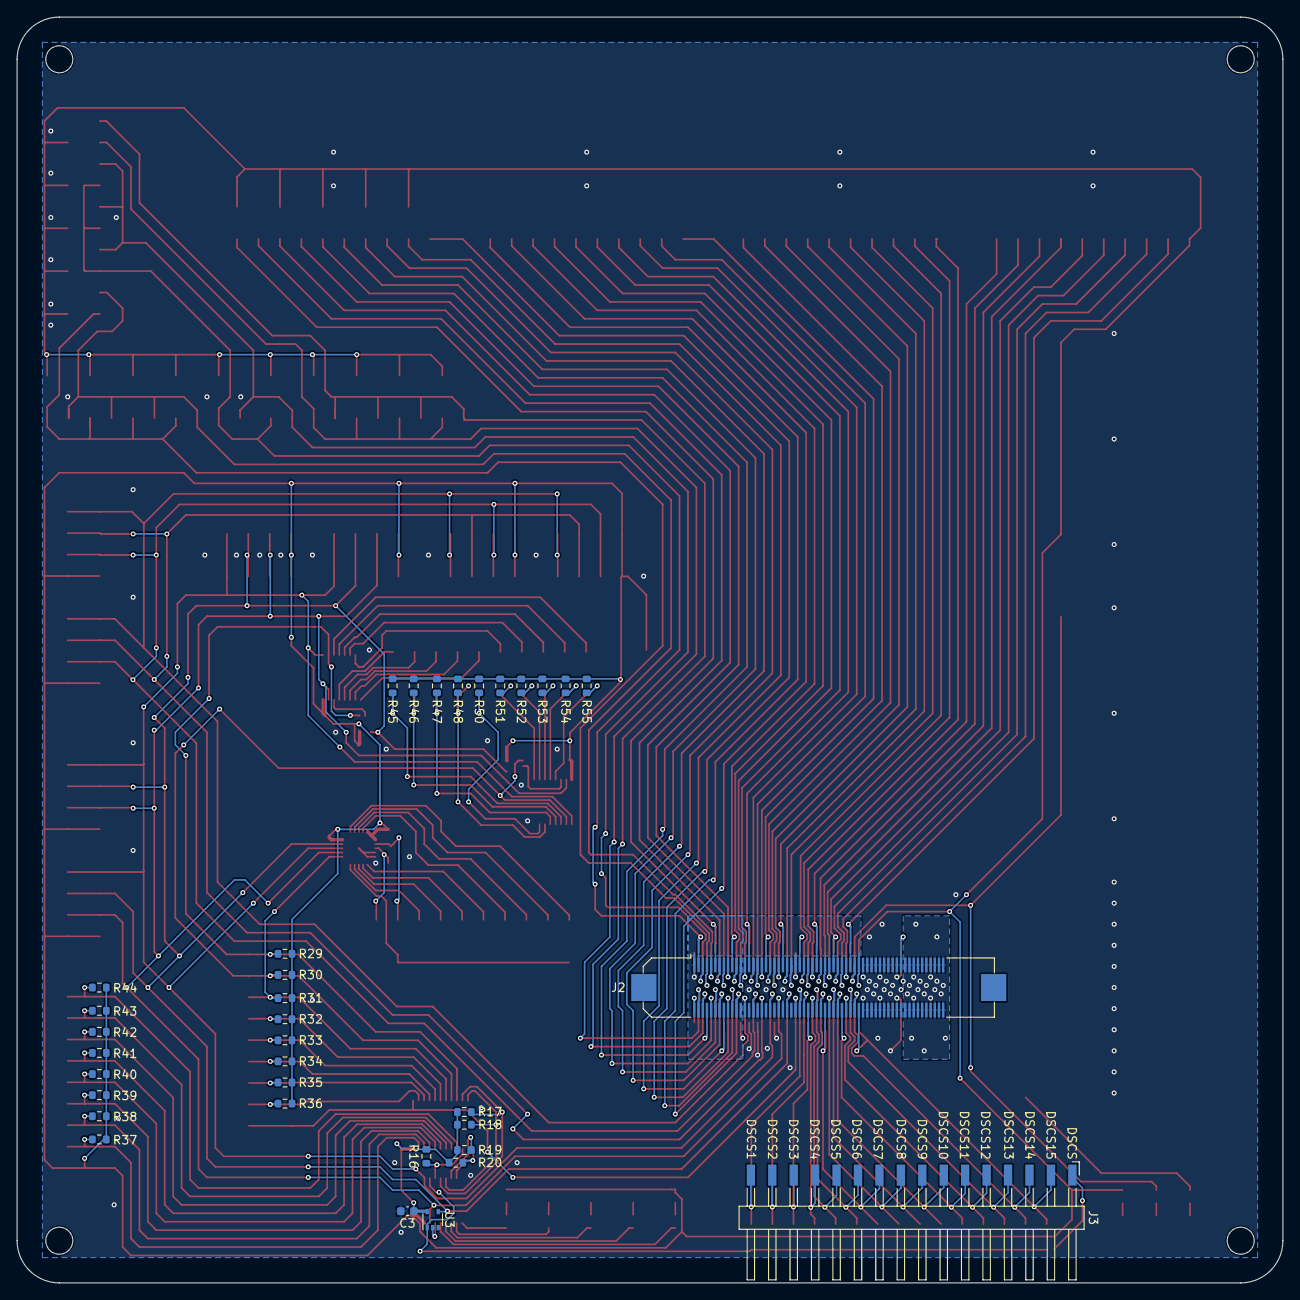
[picture p13: board ODSv1.0.0-BP-Jmp.kicad_pcb from below]

Board: 2 copper layers, 150.0 x 150.0 mm, 106 parts (35 on the bottom side), 140 nets.
