prakashlab/octopi-driver-board/(notices)

Notices in the files:
ODSv1.0.0-PP-T41/ODSv1.0.0-PP-T41.kicad_pcb:
License: SHL-2.1
Released under Solderpad Hardware License 2.1.
